lambdalaiwx/robot-car-2026/code/关键引脚 (已自动恢复).docx

P4是Tx，接RxA0

P5是Rx，接TxA1

1是红色

2是绿色

3是蓝色

左轮D9、D10

右轮D5、D6

OLED SDA ➡️ bigfish A4

OLED SCL ➡️ bigfish A5

从里到外 3，4，8，12

D12是夹爪 30°（夹紧）-90°（放松） 初始值设为90°

D8是靠近夹爪的第一关节，从根部往上数第三个关节 量程：10°（往下）-170°（往上） 初始值设为80°

D4是靠近夹爪的第二关节，从根部往上数第二个关节 量程：15°（往里）-160°（往外） 初始值设为30°

D3是靠近夹爪的第三关节，从根部往上数第一个关节 量程：75°（往里）-180°（往外） 初始值设为120°

起步转向硬编码：

// --- 动作 1：直行 ---

Serial.println("⬆️ 测试：直行 1 秒");

moveForward(150);

delay(600);

stopCar();

delay(1000);

// --- 动作 3：左转 ---

Serial.println("⬅️ 测试：原地左转 1 秒");

turnLeft(150);

delay(650);

stopCar();

delay(1000);

// --- 动作 1：直行 ---

Serial.println("⬆️ 测试：直行 1 秒");

moveForward(150);

delay(800);

stopCar();

delay(1000);

// --- 动作 2：右转 ---

Serial.println("➡️ 测试：原地右转 1 秒");

turnRight(150);

delay(400);

stopCar();

delay(2000);
